szechy/mac-hdmi-adapter/claude-notes/adi-docs-access.md

---
name: adi-docs-access
description: analog.com and snapeda.com block scripted fetches; get ADI package drawings via Wayback Machine id_ URLs
metadata:
  node_type: memory
  type: reference
  originSessionId: fbd4e7ac-0bd3-4c14-810f-10b81ce5d9c2
  modified: 2026-10-02T23:33:06.392Z
---

analog.com times out for WebFetch and curl (bot protection), and snapeda.com returns 403. ADI package drawings live at `https://www.analog.com/media/en/package-pcb-resources/package/pkg_pdf/<family>/<code>.pdf` (e.g. `lqfp_edsw/sw-64-3.pdf`). Find them with the Wayback CDX API (`web.archive.org/cdx/search/cdx?url=analog.com/media/en/package-pcb-resources/*&filter=original:.*<code>.*`), then download the raw file via `web.archive.org/web/<timestamp>id_/<url>` and read it with pdftotext. Older datasheet revisions with full outline drawings are often on docs.rs-online.com or datasheet.octopart.com.

Related: [[mac-vintage-hdmi-project]]
