szechy/mac-hdmi-adapter/mac-vintage-hdmi/production/mac-hdmi-adapter-2026109-1448_bom.csv

Designator | Footprint | Quantity | Value | LCSC Part #
C1, C10, C2, C3, C35, C4, C5, C52, C6, C7, C8, C9 | 0402 | 12 | 100n
C11, C17 | 0402 | 2 | 15pF
C12 | 0805 | 1 | 4.7uF
C13, C14 | generic_capc1005x50_wide | 2 | 4.7uF
C18, C19 | 0402 | 2 | 27pF
C20, C23, C25, C27, C29, C31, C33, C41, C43, C45, C69, C70, C73, C80, C85 | 0805 | 15 | 0.1uF
C21, C22, C24, C26, C28, C30, C32, C34, C36, C38, C40, C42, C44 | 0402 | 13 | 10nF
C37, C39, C83 | 0402 | 3 | 0.1uF
C46, C47, C48, C49, C50, C51, C53, C54, C55, C56, C57, C58, C79 | 0805 | 13 | 10uF
C67, C68, C71, C72 | 0805 | 4 | 1uF
C74, C77, C84 | 1210 | 3 | 47uF
C78 | 0805 | 1 | 47nF
C81 | 0805 | 1 | 470pF
C82 | 0805 | 1 | 1nF
D10, D11, D4, D5, D6 | 0805 | 5 | Green | LG R971-KN-1-0-20-R18
D12 | SC-59 | 1 | MA3X704A
D13, D14, D3 | 0805 | 3 | Red | LS R976-NR-1-0-20-R18
D15, D16 | 0805 | 2 | Yellow | LY R976-PS-36-0-20-R18
D7, D8 | USON-10_2.5x1.0mm_P0.5mm | 2 | RCLAMP0524PA
D9 | MLF-6-1EP_1.6x1.6mm_P0.5mm_EP0.5x1.26mm | 1 | RCLAMP0504P
FB1, FB2, FB3, FB4, FB5 | 0603 | 5 | BLM18KG601SN1D
J1 | HDMI_A_Amphenol_10029449-x01xLF_Horizontal | 1 | HDMI_A
J10, J12, J8, J9 | PinHeader_2x05_P2.54mm_Vertical_SMD | 4 | Conn_02x05_Odd_Even
J2 | USB_C_Receptacle_HRO_TYPE-C-31-M-12 | 1 | TYPE-C-31-M-12
J3, J4 | JST_SH_BM03B-SRSS-TB_1x03-1MP_P1.00mm_Vertical | 2 | BM03B-SRSS-TB
J5 | Molex_Mini-Fit_Jr_5566-14A_2x07_P4.20mm_Vertical | 1 | 39-28-1143
J6 | PinHeader_1x02_P2.54mm_Vertical_SMD_Pin1Left | 1 | Conn_01x02
L2 | L_Abracon_AOTA-B201610S3R3-101-T_2.0x1.6mm | 1 | AOTA-B201610S3R3-101-T
Q1 | SOT-23 | 1 | Si2342DS
Q10, Q2, Q3, Q4, Q5, Q6, Q9 | SOT-23 | 7 | BSS123LT1
R1, R30, R32, R34, R36, R38, R39, R40, R41, R42, R43, R44, R45, R46, R47, R56 | 0402 | 16 | 33
R10, R12, R13, R15, R2, R20, R23, R3, R73, R74, R8, R9 | 0805 | 12 | 5.1k
R14, R33, R4, R7, R75 | 0805 | 5 | 1K
R17, R29, R31 | 0805 | 3 | 2.7k
R18, R19 | 0805 | 2 | 47k
R22, R24, R25 | 0805 | 3 | 100k
R26 | 0805 | 1 | 27k
R35, R65, R66, R67 | 0805 | 4 | 100
R5, R6 | 0805 | 2 | 27
R58, R59, R60, R61, R62, R77, R78, R84 | 0402 | 8 | 0
R68, R72, R76, R85, R86, R87 | 0805 | 6 | 0
R80 | 0805 | 1 | 47
R82 | 0805 | 1 | 13k
R83 | 0805 | 1 | 8.2k
RV1 | Potentiometer_Bourns_PTV09A_RearMount | 1 | PTV09A
SW1, SW2 | SW_Push_1P1T_NO_Vertical_Wuerth_434133025816 | 2 | 434133025816
TP1, TP2, TP3, TP4, TP5 | TestPoint_Pad_2.0x2.0mm | 5 | TestPoint
U1 | LQFP-64-1EP_10x10mm_P0.5mm_EP5x5mm | 1 | ADV7611
U10, U9 | SOT-363_SC-70-6 | 2 | LM66100DCKR
U11 | SOIC-8_3.9x4.9mm_P1.27mm | 1 | LM386M-1
U12 | SOIC-8_3.9x4.9mm_P1.27mm | 1 | PT8211-S
U13 | SOT-23-5 | 1 | TLV9061IDBVR
U2 | TSSOP-14_4.4x5mm_P0.65mm | 1 | TXU0104PWR
U3 | QFN-80-1EP_10x10mm_P0.4mm_EP3.4x3.4mm | 1 | RP2354B
U4, U5 | SOT-223-3_TabPin2 | 2 | NCP1117-3.3_SOT223
U6 | SOT-223-3_TabPin2 | 1 | NCP1117ST18T3G
Y1 | Crystal_SMD_Abracon_ABM8G-4Pin_3.2x2.5mm | 1 | ABM8-272-T3
Y2 | Crystal_SMD_Abracon_ABM8G-4Pin_3.2x2.5mm | 1 | ABM8-28.63636MHZ-B2-T
