szechy/mac-hdmi-adapter/mac-vintage-hdmi/mac-vintage-hdmi.csv

Reference | Qty | Value | DNP | Footprint | Datasheet | MPN
C1,C2,C3,C4,C5,C6,C7,C8,C9,C10,C35,C52 | 12 | 100n |  | Capacitor_SMD:C_0402_1005Metric_Pad0.74x0.62mm_HandSolder
C11,C17 | 2 | 15pF |  | Capacitor_SMD:C_0402_1005Metric_Pad0.74x0.62mm_HandSolder
C18,C19 | 2 | 27pF |  | Capacitor_SMD:C_0402_1005Metric_Pad0.74x0.62mm_HandSolder
C21,C22,C24,C26,C28,C30,C32,C34,C36,C38,C40,C42,C44 | 13 | 10nF |  | Capacitor_SMD:C_0402_1005Metric_Pad0.74x0.62mm_HandSolder
C37,C39,C83 | 3 | 0.1uF |  | Capacitor_SMD:C_0402_1005Metric_Pad0.74x0.62mm_HandSolder
C12 | 1 | 4.7uF |  | Capacitor_SMD:C_0805_2012Metric_Pad1.18x1.45mm_HandSolder
C20,C23,C25,C27,C29,C31,C33,C41,C43,C45,C69,C70,C73,C80,C85 | 15 | 0.1uF |  | Capacitor_SMD:C_0805_2012Metric_Pad1.18x1.45mm_HandSolder
C46,C47,C48,C49,C50,C51,C53,C54,C55,C79 | 10 | 10uF |  | Capacitor_SMD:C_0805_2012Metric_Pad1.18x1.45mm_HandSolder
C67,C68,C71,C72 | 4 | 1uF |  | Capacitor_SMD:C_0805_2012Metric_Pad1.18x1.45mm_HandSolder
C75 | 1 | 0.1uF | DNP | Capacitor_SMD:C_0805_2012Metric_Pad1.18x1.45mm_HandSolder
C76 | 1 | 10uF | DNP | Capacitor_SMD:C_0805_2012Metric_Pad1.18x1.45mm_HandSolder
C78 | 1 | 47nF |  | Capacitor_SMD:C_0805_2012Metric_Pad1.18x1.45mm_HandSolder
C81 | 1 | 470pF |  | Capacitor_SMD:C_0805_2012Metric_Pad1.18x1.45mm_HandSolder
C82 | 1 | 1nF |  | Capacitor_SMD:C_0805_2012Metric_Pad1.18x1.45mm_HandSolder
C74,C77,C84 | 3 | 47uF |  | Capacitor_SMD:C_1210_3225Metric_Pad1.33x2.70mm_HandSolder
J1 | 1 | HDMI_A |  | Connector_Video:HDMI_A_Amphenol_10029449-x01xLF_Horizontal | https://en.wikipedia.org/wiki/HDMI
D3,D13,D14 | 3 | Red |  | LED_SMD:LED_0805_2012Metric_Pad1.15x1.40mm_HandSolder |  | LS R976-NR-1-0-20-R18
D4,D5,D6,D10,D11 | 5 | Green |  | LED_SMD:LED_0805_2012Metric_Pad1.15x1.40mm_HandSolder |  | LG R971-KN-1-0-20-R18
D15,D16 | 2 | Yellow |  | LED_SMD:LED_0805_2012Metric_Pad1.15x1.40mm_HandSolder |  | LY R976-PS-36-0-20-R18
Y1 | 1 | ABM8-272-T3 |  | mac-vintage-hdmi:Crystal_SMD_Abracon_ABM8G-4Pin_3.2x2.5mm | https://abracon.com/Resonators/abm8.pdf
Y2 | 1 | ABM8-28.63636MHZ-B2-T |  | mac-vintage-hdmi:Crystal_SMD_Abracon_ABM8G-4Pin_3.2x2.5mm | https://abracon.com/Resonators/abm8.pdf
C13,C14 | 2 | 4.7uF |  | mac-vintage-hdmi:generic_capc1005x50_wide
J3,J4 | 2 | BM03B-SRSS-TB |  | mac-vintage-hdmi:JST_SH_BM03B-SRSS-TB_1x03-1MP_P1.00mm_Vertical | https://www.jst-mfg.com/product/pdf/eng/eSH.pdf
FB1,FB2,FB3 | 3 | BLM18KG601SN1D |  | mac-vintage-hdmi:L_0603_1608Metric_Pad1.05x0.95mm_HandSolder | https://www.murata.com/en-us/products/productdetail?partno=BLM18KG601SN1%23
L2 | 1 | AOTA-B201610S3R3-101-T |  | mac-vintage-hdmi:L_Abracon_AOTA-B201610S3R3-101-T_2.0x1.6mm | https://abracon.com/datasheets/AOTA-B201610S3R3-101-T.pdf
U1 | 1 | ADV7611 |  | mac-vintage-hdmi:LQFP-64-1EP_10x10mm_P0.5mm_EP5x5mm | https://www.analog.com/media/en/technical-documentation/data-sheets/adv7611.pdf
D9 | 1 | RCLAMP0504P |  | mac-vintage-hdmi:MLF-6-1EP_1.6x1.6mm_P0.5mm_EP0.5x1.26mm | https://www.semtech.com/products/circuit-protection/low-capacitance/rclamp0504p
J5 | 1 | 39-28-1143 |  | mac-vintage-hdmi:Molex_Mini-Fit_Jr_5566-14A_2x07_P4.20mm_Vertical | https://www.molex.com/en-us/products/part-detail/39281143
J6 | 1 | Conn_01x02 |  | mac-vintage-hdmi:PinHeader_1x02_P2.54mm_Vertical_SMD_Pin1Left
J8,J9,J10,J12 | 4 | Conn_02x05_Odd_Even |  | mac-vintage-hdmi:PinHeader_2x05_P2.54mm_Vertical_SMD
RV1 | 1 | PTV09A |  | mac-vintage-hdmi:Potentiometer_Bourns_PTV09A_RearMount | https://www.bourns.com/docs/Product-Datasheets/ptv09.pdf
U3 | 1 | RP2354B |  | mac-vintage-hdmi:QFN-80-1EP_10x10mm_P0.4mm_EP3.4x3.4mm | https://datasheets.raspberrypi.com/rp2350/rp2350-datasheet.pdf
D12 | 1 | MA3X704A |  | mac-vintage-hdmi:SC-59 | https://datasheet4u.com/datasheet/Panasonic/MA3X704A-402407
U11 | 1 | LM386M-1 |  | mac-vintage-hdmi:SOIC-8_3.9x4.9mm_P1.27mm | http://www.ti.com/lit/ds/symlink/lm386.pdf
U12 | 1 | PT8211-S |  | mac-vintage-hdmi:SOIC-8_3.9x4.9mm_P1.27mm | https://datasheet.lcsc.com/datasheet/pdf/7727b839d35ab598f7be71011fce1b56.pdf?productCode=C5260468
Q1 | 1 | Si2342DS |  | mac-vintage-hdmi:SOT-23 | https://www.vishay.com/docs/63302/si2342ds.pdf
Q2,Q3,Q4,Q5,Q6,Q9,Q10 | 7 | BSS123LT1 |  | mac-vintage-hdmi:SOT-23 | https://www.onsemi.com/pdf/datasheet/bss123lt1-d.pdf
U6 | 1 | NCP1117ST18T3G |  | mac-vintage-hdmi:SOT-223-3_TabPin2 | http://www.onsemi.com/pub_link/Collateral/NCP1117-D.PDF
U13 | 1 | TLV9061IDBVR |  | mac-vintage-hdmi:SOT-23-5 | https://www.ti.com/lit/ds/symlink/tlv9061.pdf
U9,U10 | 2 | LM66100DCKR |  | mac-vintage-hdmi:SOT-363_SC-70-6 | https://www.ti.com/lit/ds/symlink/lm66100.pdf
SW1,SW2 | 2 | 434133025816 |  | mac-vintage-hdmi:SW_Push_1P1T_NO_Vertical_Wuerth_434133025816 | https://www.we-online.com/components/products/datasheet/434133025816.pdf
U2 | 1 | TXU0104PWR |  | mac-vintage-hdmi:TSSOP-14_4.4x5mm_P0.65mm | https://www.ti.com/lit/ds/symlink/txu0104.pdf
J2 | 1 | TYPE-C-31-M-12 |  | mac-vintage-hdmi:USB_C_Receptacle_HRO_TYPE-C-31-M-12 | https://www.lcsc.com/datasheet/C165948.pdf
D7,D8 | 2 | RCLAMP0524PA |  | mac-vintage-hdmi:USON-10_2.5x1.0mm_P0.5mm | https://www.semtech.com/products/circuit-protection/low-capacitance/rclamp0524pa
U4,U5 | 2 | NCP1117-3.3_SOT223 |  | Package_TO_SOT_SMD:SOT-223-3_TabPin2 | http://www.onsemi.com/pub_link/Collateral/NCP1117-D.PDF
R1,R30,R32,R34,R36,R38,R39,R40,R41,R42,R43,R44,R45,R46,R47,R56 | 16 | 33 |  | Resistor_SMD:R_0402_1005Metric_Pad0.72x0.64mm_HandSolder
R58,R59,R60,R61,R62,R77,R78,R84 | 8 | 0 |  | Resistor_SMD:R_0402_1005Metric_Pad0.72x0.64mm_HandSolder
R64,R69,R81 | 3 | 0 | DNP | Resistor_SMD:R_0402_1005Metric_Pad0.72x0.64mm_HandSolder
R2,R3,R8,R9,R10,R12,R13,R15,R20,R23,R73,R74 | 12 | 5.1k |  | Resistor_SMD:R_0805_2012Metric_Pad1.20x1.40mm_HandSolder
R4,R33,R75 | 3 | 1k |  | Resistor_SMD:R_0805_2012Metric_Pad1.20x1.40mm_HandSolder
R5,R6 | 2 | 27 |  | Resistor_SMD:R_0805_2012Metric_Pad1.20x1.40mm_HandSolder
R7,R14 | 2 | 1K |  | Resistor_SMD:R_0805_2012Metric_Pad1.20x1.40mm_HandSolder
R11 | 1 | 10k | DNP | Resistor_SMD:R_0805_2012Metric_Pad1.20x1.40mm_HandSolder
R17,R29,R31 | 3 | 2.7k |  | Resistor_SMD:R_0805_2012Metric_Pad1.20x1.40mm_HandSolder
R18,R19 | 2 | 47k |  | Resistor_SMD:R_0805_2012Metric_Pad1.20x1.40mm_HandSolder
R21 | 1 | 390k | DNP | Resistor_SMD:R_0805_2012Metric_Pad1.20x1.40mm_HandSolder
R22,R24,R25 | 3 | 100k |  | Resistor_SMD:R_0805_2012Metric_Pad1.20x1.40mm_HandSolder
R26 | 1 | 27k |  | Resistor_SMD:R_0805_2012Metric_Pad1.20x1.40mm_HandSolder
R35,R65,R66,R67 | 4 | 100 |  | Resistor_SMD:R_0805_2012Metric_Pad1.20x1.40mm_HandSolder
R68,R72,R76,R85,R86,R87 | 6 | 0 |  | Resistor_SMD:R_0805_2012Metric_Pad1.20x1.40mm_HandSolder
R70,R71 | 2 | 0 | DNP | Resistor_SMD:R_0805_2012Metric_Pad1.20x1.40mm_HandSolder
R79 | 1 | 5.1k | DNP | Resistor_SMD:R_0805_2012Metric_Pad1.20x1.40mm_HandSolder
R80 | 1 | 47 |  | Resistor_SMD:R_0805_2012Metric_Pad1.20x1.40mm_HandSolder
R82 | 1 | 13k |  | Resistor_SMD:R_0805_2012Metric_Pad1.20x1.40mm_HandSolder
R83 | 1 | 8.2k |  | Resistor_SMD:R_0805_2012Metric_Pad1.20x1.40mm_HandSolder
TP1,TP2,TP3,TP4,TP5 | 5 | TestPoint |  | TestPoint:TestPoint_Pad_2.0x2.0mm
