szechy/mac-hdmi-adapter/mac-vintage-hdmi/mac-vintage-hdmi.kicad_pcb

## KiCad design mac-vintage-hdmi/mac-vintage-hdmi.kicad_pcb (2026-10-20)

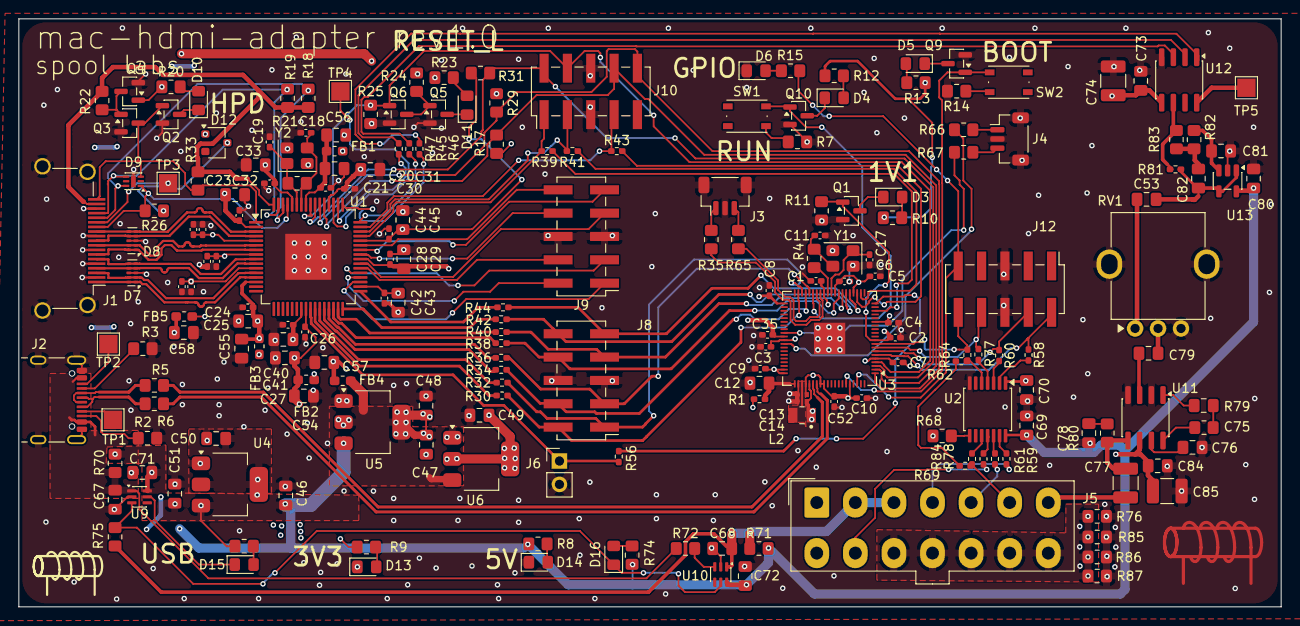
[picture p1: board mac-vintage-hdmi.kicad_pcb from above]

Board: 4 copper layers, 137.4 x 64.0 mm, 207 parts (0 on the bottom side), 154 nets.

Parts:
C1, C2, C3, C4, C5, C6, C7, C8, C9, C10, C35, C37, C39, C52, C83: 100nF; C_0402_1005Metric_Pad0.74x0.62mm_HandSolder
C11, C17: 15pF; C_0402_1005Metric_Pad0.74x0.62mm_HandSolder
C12: 4.7uF; C_0805_2012Metric_Pad1.18x1.45mm_HandSolder
C13, C14: 4.7uF; generic_capc1005x50_wide
C18, C19: 27pF; C_0402_1005Metric_Pad0.74x0.62mm_HandSolder
C20, C23, C25, C27, C29, C31, C33, C41, C43, C45, C69, C70, C73, C75, C80, C85: 100nF; C_0805_2012Metric_Pad1.18x1.45mm_HandSolder
C21, C22, C24, C26, C28, C30, C32, C34, C36, C38, C40, C42, C44: 10nF; C_0402_1005Metric_Pad0.74x0.62mm_HandSolder
C46, C47, C48, C49, C50, C51, C53, C54, C55, C56, C57, C58, C76, C79: 10uF; C_0805_2012Metric_Pad1.18x1.45mm_HandSolder
C67, C68, C71, C72: 1uF; C_0805_2012Metric_Pad1.18x1.45mm_HandSolder
C74, C77, C84: 47uF; C_1210_3225Metric_Pad1.33x2.70mm_HandSolder
C78: 47nF; C_0805_2012Metric_Pad1.18x1.45mm_HandSolder
C81: 470pF; C_0805_2012Metric_Pad1.18x1.45mm_HandSolder
C82: 1nF; C_0805_2012Metric_Pad1.18x1.45mm_HandSolder
D3, D13, D14: Red; LED_0805_2012Metric_Pad1.15x1.40mm_HandSolder
D4, D5, D6, D10, D11: Green; LED_0805_2012Metric_Pad1.15x1.40mm_HandSolder
D7, D8: RCLAMP0524PATCT; USON-10_2.5x1.0mm_P0.5mm
D9: RCLAMP0504P; MLF-6-1EP_1.6x1.6mm_P0.5mm_EP0.5x1.26mm
D12: MA3X704A; SC-59
D15, D16: Yellow; LED_0805_2012Metric_Pad1.15x1.40mm_HandSolder
FB1, FB2, FB3, FB4, FB5: BLM18KG601SN1D; L_0603_1608Metric_Pad1.05x0.95mm_HandSolder
J1: HDMI_A; HDMI_A_Amphenol_10029449-x01xLF_Horizontal
J2: TYPE-C-31-M-12; USB_C_Receptacle_HRO_TYPE-C-31-M-12
J3, J4: BM03B-SRSS-TB; JST_SH_BM03B-SRSS-TB_1x03-1MP_P1.00mm_Vertical
J5: 39-28-1143; Molex_Mini-Fit_Jr_5566-14A_2x07_P4.20mm_Vertical
J6: HX PZ2.54-1x2P ZZ; PinHeader_1x02_P2.54mm_Vertical
J8, J9, J10, J12: Conn_02x05_Odd_Even; PinHeader_2x05_P2.54mm_Vertical_SMD
L2: AOTA-B201610S3R3-101-T; L_Abracon_AOTA-B201610S3R3-101-T_2.0x1.6mm
Q1: Si2342DS; SOT-23
Q2, Q3, Q4, Q5, Q6, Q9, Q10: BSS123LT1; SOT-23
R1, R30, R32, R34, R36, R38, R39, R40, R41, R42, R43, R44, R45, R46, R47, R56: 33; R_0402_1005Metric_Pad0.72x0.64mm_HandSolder
R2, R3, R79: 5.1k; R_0805_2012Metric_Pad1.20x1.40mm_HandSolder
R4, R7, R9, R14, R33, R75: 1k; R_0805_2012Metric_Pad1.20x1.40mm_HandSolder
R5, R6: 27; R_0805_2012Metric_Pad1.20x1.40mm_HandSolder
R8, R10, R12, R13, R15, R17, R20, R23, R29, R31, R73, R74: 2.7k; R_0805_2012Metric_Pad1.20x1.40mm_HandSolder
R11: 10k; R_0805_2012Metric_Pad1.20x1.40mm_HandSolder
R18, R19: 47k; R_0805_2012Metric_Pad1.20x1.40mm_HandSolder
R21: 390k; R_0805_2012Metric_Pad1.20x1.40mm_HandSolder
R22, R24, R25: 100k; R_0805_2012Metric_Pad1.20x1.40mm_HandSolder
R26: 27k; R_0805_2012Metric_Pad1.20x1.40mm_HandSolder
R35, R65, R66, R67: 100; R_0805_2012Metric_Pad1.20x1.40mm_HandSolder
R58, R59, R60, R61, R62, R64, R69, R77, R78, R81, R84: 0; R_0402_1005Metric_Pad0.72x0.64mm_HandSolder
R68, R70, R71, R72, R76, R85, R86, R87: 0; R_0805_2012Metric_Pad1.20x1.40mm_HandSolder
R80: 47; R_0805_2012Metric_Pad1.20x1.40mm_HandSolder
R82: 13k; R_0805_2012Metric_Pad1.20x1.40mm_HandSolder
R83: 8.2k; R_0805_2012Metric_Pad1.20x1.40mm_HandSolder
RV1: PTV09A; Potentiometer_Bourns_PTV09A_RearMount
SW1, SW2: 434133025816; SW_Push_1P1T_NO_Vertical_Wuerth_434133025816
TP1, TP2, TP3, TP4, TP5: TestPoint; TestPoint_Pad_2.0x2.0mm
U1: ADV7611BSWZ; LQFP-64-1EP_10x10mm_P0.5mm_EP5x5mm
U2: TXU0104PWR; TSSOP-14_4.4x5mm_P0.65mm
U3: RP2354B; QFN-80-1EP_10x10mm_P0.4mm_EP3.4x3.4mm
U4, U5: NCP1117-3.3_SOT223; SOT-223-3_TabPin2
U6: NCP1117ST18T3G; SOT-223-3_TabPin2
U9, U10: LM66100DCKR; SOT-363_SC-70-6
U11: LM386M-1; SOIC-8_3.9x4.9mm_P1.27mm
U12: TM8211-TA2302; SOIC-8_3.9x4.9mm_P1.27mm
U13: TLV9061IDBVR; SOT-23-5
Y1: ABM8-272-T3; Crystal_SMD_Abracon_ABM8G-4Pin_3.2x2.5mm
Y2: ABM8-28.63636MHZ-B2-T; Crystal_SMD_Abracon_ABM8G-4Pin_3.2x2.5mm

Connections:
+1V1: C1.1, C2.1, C3.1, C14.1, L2.1, Q1.1 (G), R11.1, U3.10 (DVDD), U3.32 (DVDD), U3.51 (DVDD), U3.65 (VREG_FB)
+3V3: C4.1, C5.1, C6.1, C7.1, C8.1, C9.1, C10.1, C13.1, C35.1, C50.1, C52.1, C70.1, C73.1, C74.1, D12.1 (A), R1.1, R9.1, R17.1, R29.1, U2.1 (VCCA), U3.5 (IOVDD), U3.15 (IOVDD), U3.24 (IOVDD), U3.29 (IOVDD), U3.41 (IOVDD), U3.50 (IOVDD), U3.59 (ADC_AVDD), U3.60 (IOVDD), U3.64 (VREG_VIN), U3.68 (USB_OTP_VDD), U3.69 (QSPI_IOVDD), U3.76 (IOVDD), U4.2 (VO), U12.5 (VDD)
+5V: C46.1, C51.1, C69.1, C71.1, C72.1, C80.1, Q3.1 (G), R8.1, R10.1, R12.1, R13.1, R20.1, R23.1, R24.1, R68.1, R70.2, R71.2, R73.1, R74.1, U2.14 (VCCB), U4.3 (VI), U5.3 (VI), U9.6 (VOUT), U10.6 (VOUT), U13.5 (V+)
+5V_HDMI: J1.18 (+5V), R18.1, R19.1, R22.1, R33.1, U1.64 (RXA_5V)
+5V_MAC: C68.1, J5.2, J5.3, R71.1, R75.1, U10.1 (VIN)
+5V_USB: C67.1, J2.A4/B9 (VBUS), J2.B4/A9 (VBUS), R70.1, R72.1, U9.1 (VIN)
+12V_MAC: C84.1, C85.2, J5.1, U11.6 (V+)
/Data/ADV7611_CB0CR0: J9.10, U1.43 (P0)
/Data/ADV7611_CB1CR1: J9.9, U1.42 (P1)
/Data/ADV7611_CB2CR2: J9.8, U1.41 (P2)
/Data/ADV7611_CB3CR3: J9.7, U1.39 (P3)
/Data/ADV7611_CB4CR4: J9.4, U1.38 (P4)
/Data/ADV7611_CB5CR5: J9.3, U1.37 (P5)
/Data/ADV7611_CB6CR6: J9.2, U1.36 (P6)
/Data/ADV7611_CB7CR7: J9.1, U1.35 (P7)
/Data/ADV7611_DE: J10.1, R39.1, U1.45 (DE)
/Data/ADV7611_DE_RP2350: R39.2, U3.18 (GPIO18)
/Data/ADV7611_HS: J10.3, R41.1, U1.46 (HS)
/Data/ADV7611_HS_RP2350: R41.2, U3.22 (GPIO22)
/Data/ADV7611_INT1: J10.2, R31.2, U1.55 (INT1), U3.3 (GPIO6)
/Data/ADV7611_LLC: J6.1, R56.1, U1.25 (LLC)
/Data/ADV7611_LLC_RP2350: R56.2, U3.20 (GPIO20)
/Data/ADV7611_RESET_L: J10.4, Q6.1 (G), R25.1, U1.56 (~RESET), U3.4 (GPIO7)
/Data/ADV7611_VS: J10.7, R43.1, U1.47 (VS/FIELD/ALSB)
/Data/ADV7611_VS_RP2350: R43.2, U3.23 (GPIO23)
/Data/ADV7611_Y0: R44.1, U1.33 (P8)
/Data/ADV7611_Y0_RP2350: J8.9, R44.2, U3.25 (GPIO24)
/Data/ADV7611_Y1: R42.1, U1.32 (P9)
/Data/ADV7611_Y1_RP2350: J8.10, R42.2, U3.26 (GPIO25)
/Data/ADV7611_Y2: R40.1, U1.31 (P10)
/Data/ADV7611_Y2_RP2350: J8.7, R40.2, U3.27 (GPIO26)
/Data/ADV7611_Y3: R38.1, U1.30 (P11)
/Data/ADV7611_Y3_RP2350: J8.8, R38.2, U3.28 (GPIO27)
/Data/ADV7611_Y4: R36.1, U1.29 (P12)
/Data/ADV7611_Y4_RP2350: J8.3, R36.2, U3.36 (GPIO28)
/Data/ADV7611_Y5: R34.1, U1.28 (P13)
/Data/ADV7611_Y5_RP2350: J8.4, R34.2, U3.37 (GPIO29)
/Data/ADV7611_Y6: R32.1, U1.27 (P14)
/Data/ADV7611_Y6_RP2350: J8.1, R32.2, U3.38 (GPIO30)
/Data/ADV7611_Y7: R30.1, U1.26 (P15)
/Data/ADV7611_Y7_RP2350: J8.2, R30.2, U3.39 (GPIO31)
/Data/HDMI_CEC: D9.1 (IO1), J1.13 (CEC), R26.2, U1.61 (CEC)
/Data/HDMI_CLK_N: D8.5 (IO4), D8.6 (NC), J1.12 (CK-), U1.3 (RXA_C-)
/Data/HDMI_CLK_P: D8.4 (IO3), D8.7 (NC), J1.10 (CK+), U1.4 (RXA_C+)
/Data/HDMI_DDC_SCL: D9.6 (IO4), J1.15 (SCL), R18.2, U1.62 (DDCA_SCL)
/Data/HDMI_DDC_SDA: D9.4 (IO3), J1.16 (SDA), R19.2, U1.63 (DDCA_SDA)
/Data/HDMI_HPD: D9.3 (IO2), J1.19 (HPD), Q2.1 (G), Q4.3 (D), R33.2, U1.1 (HPA_A/INT2)
/Data/HDMI_LN0_N: D8.2 (IO2), D8.9 (NC), J1.9 (D0-), U1.6 (RXA_0-)
/Data/HDMI_LN0_P: D8.1 (IO1), D8.10 (NC), J1.7 (D0+), U1.7 (RXA_0+)
/Data/HDMI_LN1_N: D7.5 (IO4), D7.6 (NC), J1.6 (D1-), U1.9 (RXA_1-)
/Data/HDMI_LN1_P: D7.4 (IO3), D7.7 (NC), J1.4 (D1+), U1.10 (RXA_1+)
/Data/HDMI_LN2_N: D7.2 (IO2), D7.9 (NC), J1.3 (D2-), U1.12 (RXA_2-)
/Data/HDMI_LN2_P: D7.1 (IO1), D7.10 (NC), J1.1 (D2+), U1.13 (RXA_2+)
/Data/I2C_ADV7611_SCL: J10.8, R17.2, U1.53 (SCL), U3.2 (GPIO5)
/Data/I2C_ADV7611_SDA: J10.10, R29.2, U1.54 (SDA), U3.1 (GPIO4)
/Data/I2S_ADV7611_DOUT_R: R45.1, U1.48 (AP)
/Data/I2S_ADV7611_LRCLK_R: R47.1, U1.50 (LRCLK)
/Data/I2S_ADV7611_SCLK_R: R46.1, U1.49 (SCLK/INT2)
/Data/RP2350_BOOTSEL: Q9.1 (G), SW2.4, U3.75 (~QSPI_SS)
/Data/RP2350_GPIO_LED: J12.9, R15.1, U3.78 (GPIO1)
/Data/RP2350_RUN: Q10.1 (G), SW1.3, U3.35 (RUN)
/Data/SWD_RP2350_SWCLK: R35.1, U3.33 (SWCLK)
/Data/SWD_RP2350_SWDIO: R65.1, U3.34 (SWDIO)
/Data/UART_RP2350_RX: R66.1, U3.52 (GPIO41/ADC1)
/Data/UART_RP2350_TX: R67.1, U3.49 (GPIO40/ADC0)
/Data/USB2_D_R_N: R5.2, U3.66 (USB_DM)
/Data/USB2_D_R_P: R6.2, U3.67 (USB_DP)
/Data/VREG_AVDD: C12.1, R1.2, U3.61 (VREG_AVDD)
/Power/5V_MAC_ST_L: D16.1 (K), R75.2, U9.3 (~CE), U10.5 (ST)
/Power/5V_USB_ST_L: D15.1 (K), U9.5 (ST)
/Power/+1V8_ADV7611: C49.1, FB1.1, FB2.1, FB3.1, U6.2 (VO)
/Power/+3V3_ADV7611: C47.1, C48.1, FB4.1, FB5.1, U5.2 (VO), U6.3 (VI)
/Power/J5_GND: J5.10, J5.11, J5.12, J5.13, J5.14, R76.1, R85.1, R86.1, R87.1
/Power/MAC_HSYNC_3V3: R60.2, U2.3 (A2)
/Power/MAC_HSYNC_5V: J5.5, R61.2
/Power/MAC_PWM_3V3: R77.2, U2.4 (A3)
/Power/MAC_PWM_5V: J5.9, R78.2
/Power/MAC_SOUND: C77.1, J5.7
/Power/MAC_VIDOUT: R64.2, R69.1
/Power/MAC_VIDOUT_3V3: R62.2, R64.1, U2.5 (A4)
/Power/MAC_VIDOUT_5V: J5.6, R69.2, R84.2
/Power/MAC_VSYNC_3V3: R58.2, U2.2 (A1)
/Power/MAC_VSYNC_5V: J5.4, R59.2
/Power/USB2_CC1: J2.A5 (CC1), R3.1
/Power/USB2_CC2: J2.B5 (CC2), R2.1
/Power/USB2_SBU1: J2.A8 (SBU1), TP1.1 (1_1)
/Power/USB2_SBU2: J2.B8 (SBU2), TP2.1 (1_1)
ADV7611_CVDD_1V8: C22.1, C23.1, C24.1, C25.1, C55.1, FB3.2, U1.2 (CVDD), U1.14 (CVDD)
ADV7611_DVDDIO_3V3: C40.1, C41.1, C42.1, C43.1, C44.1, C45.1, C57.1, FB4.2, R31.1, U1.23 (DVDDIO), U1.34 (DVDDIO), U1.44 (DVDDIO)
ADV7611_DVDD_1V8: C26.1, C27.1, C28.1, C29.1, C30.1, C31.1, C32.1, C33.1, C54.1, FB2.2, U1.24 (DVDD), U1.40 (DVDD), U1.52 (DVDD), U1.60 (DVDD)
ADV7611_PVDD_1V8: C20.1, C21.1, C56.1, FB1.2, U1.57 (PVDD)
ADV7611_TVDD_3V3: C34.1, C36.1, C37.1, C38.1, C39.1, C58.1, C83.1, FB5.2, U1.5 (TVDD), U1.8 (TVDD), U1.11 (TVDD)
GND: C1.2, C2.2, C3.2, C4.2, C5.2, C6.2, C7.2, C8.2, C9.2, C10.2, C11.2, C12.2, C13.2, C14.2, C17.1, C18.1, C19.1, C20.2, C21.2, C22.2, C23.2, C24.2, C25.2, C26.2, C27.2, C28.2, C29.2, C30.2, C31.2, C32.2, C33.2, C34.2, C35.2, C36.2, C37.2, C38.2, C39.2, C40.2, C41.2, C42.2, C43.2, C44.2, C45.2, C46.2, C47.2, C48.2, C49.2, C50.2, C51.2, C52.2, C54.2, C55.2, C56.2, C57.2, C58.2, C67.2, C68.2, C69.2, C70.2, C71.2, C72.2, C73.2, C74.2, C76.1, C78.2, C80.2, C81.2, C83.2, C84.2, C85.1, D6.1 (K), D7.3 (GND), D7.8 (GND), D8.3 (GND), D8.8 (GND), D9.7 (GND), D13.1 (K), D14.1 (K), J1.2 (D2S), J1.5 (D1S), J1.8 (D0S), J1.11 (CKS), J1.17 (GND), J1.SH, J2.A1/B12 (GND), J2.B1/A12 (GND), J2.S1 (SHIELD), J2.S2 (SHIELD), J2.S3 (SHIELD), J2.S4 (SHIELD), J3.2, J3.MP1 (MountPin_1), J3.MP2 (MountPin_2), J4.2, J4.MP1 (MountPin_1), J4.MP2 (MountPin_2), J6.2, J8.5, J8.6, J9.5, J9.6, J10.5, J10.6, J12.5, J12.6, Q1.2 (S), Q2.2 (S), Q3.2 (S), Q4.2 (S), Q5.2 (S), Q6.2 (S), Q9.2 (S), Q10.2 (S), R2.2, R3.2, R7.2, R11.2, R14.2, R25.2, R76.2, R85.2, R86.2, R87.2, RV1.3, RV1.4 (MP), RV1.5 (MP), U1.65 (GND), U2.7 (GND), U3.62 (VREG_PGND), U3.81 (GND), U4.1 (GND), U5.1 (GND), U6.1 (GND), U9.2 (GND), U10.2 (GND), U11.2 (-), U11.4 (GND), U12.4 (GND), U13.2 (V-), Y1.2 (G), Y1.4 (G), Y2.2 (G), Y2.4 (G)
I2S_ADV7611_DOUT: R45.2, U12.3 (DIN)
I2S_ADV7611_LRCLK: R47.2, U12.2 (WS)
I2S_ADV7611_SCLK: R46.2, U12.1 (BCK)
MAC_HSYNC_3V3_RP2350: J12.4, R60.1, U3.7 (GPIO9)
MAC_PWM_3V3_RP2350: J12.8, R77.1, U3.8 (GPIO10)
MAC_VIDOUT_3V3_RP2350: J12.10, R62.1, U3.9 (GPIO11)
MAC_VSYNC_3V3_RP2350: J12.2, R58.1, U3.6 (GPIO8)
unnamed: C11.1, R4.2, Y1.3
unnamed: C53.1, RV1.1
unnamed: C75.1, R79.2
unnamed: C75.2, U11.1 (GAIN)
unnamed: C77.2, R80.1, U11.5
unnamed: C78.1, R80.2
unnamed: C79.2, RV1.2
unnamed: C82.2, R82.2, R83.1
unnamed: D3.2 (A), R10.2
unnamed: D3.1 (K), Q1.3 (D)
unnamed: D4.2 (A), R12.2
unnamed: D4.1 (K), Q10.3 (D)
unnamed: D5.2 (A), R13.2
unnamed: D5.1 (K), Q9.3 (D)
unnamed: D6.2 (A), R15.2
unnamed: D10.2 (A), R20.2
unnamed: D10.1 (K), Q2.3 (D)
unnamed: D11.2 (A), R23.2
unnamed: D11.1 (K), Q5.3 (D)
unnamed: D12.3 (K), R26.1
unnamed: D13.2 (A), R9.2
unnamed: D14.2 (A), R8.2
unnamed: D15.2 (A), R73.2
unnamed: D16.2 (A), R74.2
unnamed: J1.14 (UTILITY), TP3.1 (1_1)
unnamed: J3.1, R35.2
unnamed: J3.3, R65.2
unnamed: J4.1, R66.2
unnamed: J4.3, R67.2
unnamed: Q3.3 (D), Q4.1 (G), R22.2
unnamed: Q5.1 (G), Q6.3 (D), R24.2
unnamed: R7.1, SW1.1
unnamed: R14.1, SW2.2
unnamed: R79.1, U11.8 (GAIN)
unnamed: TP4.1 (1_1), U1.51 (MCLK/INT2)
unnamed: C19.2, R21.2, U1.59 (XTALN), Y2.1
unnamed: C18.2, R21.1, U1.58 (XTALP), Y2.3
unnamed: R59.1, U2.13 (B1Y)
unnamed: R61.1, U2.12 (B2Y)
unnamed: R78.1, U2.11 (B3Y)
unnamed: R84.1, U2.10 (B4Y)
unnamed: R68.2, U2.8 (OE)
unnamed: L2.2, U3.63 (VREG_LX)
unnamed: C17.2, U3.30 (XIN), Y1.1
unnamed: R4.1, U3.31 (XOUT)
unnamed: R72.2, U10.3 (~CE)
unnamed: C79.1, U11.3 (+)
unnamed: C76.2, U11.7 (BYPASS)
unnamed: R81.1, R82.1, U12.6 (LCH)
unnamed: TP5.1 (1_1), U12.8 (RCH)
unnamed: C81.1, R83.2, U13.3 (+)
unnamed: C53.2, C82.1, R81.2, U13.1, U13.4 (-)
USB2_D_N: J2.A7 (D-), J2.B7 (D-), R5.1
USB2_D_P: J2.A6 (D+), J2.B6 (D+), R6.1
