szechy/mac-hdmi-adapter/(commit log)

2026-10-14 Initial commit pre-placement
    [mac-vintage-hdmi.kicad_pcb, mac-vintage-hdmi.kicad_sch, power.kicad_sch]
2026-10-14 more placement
    [mac-vintage-hdmi.kicad_pcb, power.kicad_sch]
2026-10-19 ready for design review
    [jlcpcb_4L_1.6mm_outer1oz_inner0.5oz_JLC04161H-7628.kicad_pcb, mac-vintage-hdmi.kicad_pcb, mac-vintage-hdmi.kicad_sch, power.kicad_sch]
2026-10-20 near prod ready
    [mac-hdmi-adapter-2026109-1448_bom.csv, mac-hdmi-adapter-2026109-1448_designators.csv, mac-hdmi-adapter-2026109-1448_positions.csv, mac-vintage-hdmi.csv, mac-vintage-hdmi.kicad_pcb, mac-vintage-hdmi.kicad_sch, power.kicad_sch]
2026-10-20 added production export
    [mac-hdmi-adapter-2026109-2142_bom.csv, mac-hdmi-adapter-2026109-2142_designators.csv, mac-hdmi-adapter-2026109-2142_positions.csv, mac-vintage-hdmi.kicad_pcb, mac-vintage-hdmi.kicad_sch, power.kicad_sch]
